FumBlau/DropAlert/Hardware/Drop_no sleep/outputs proyecto/Drop_back.jpg

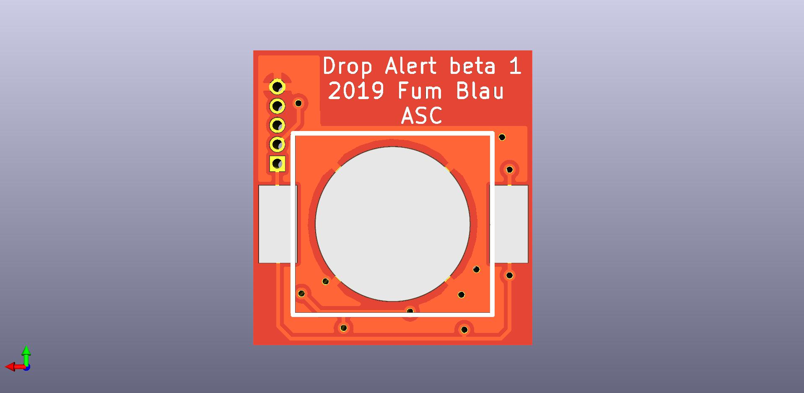
Hardware/Drop_no sleep/outputs proyecto/Drop_back.jpg
