FumBlau/DropAlert/Hardware/Drop_no sleep/outputs proyecto/Drop_front.jpg

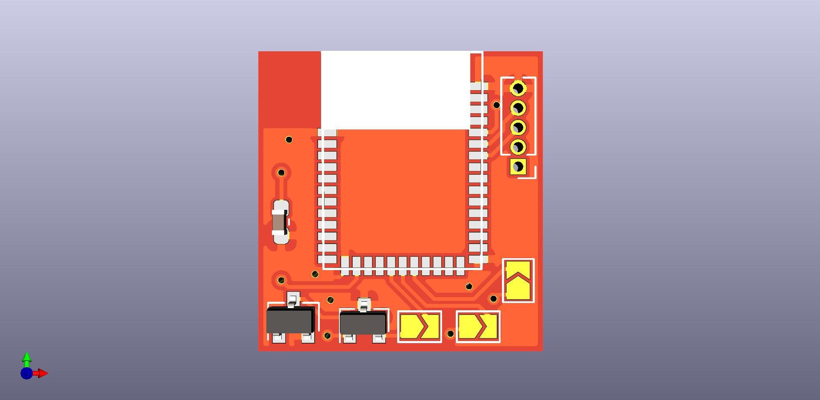
Hardware/Drop_no sleep/outputs proyecto/Drop_front.jpg
