FumBlau/DropAlert/README.md

# DropAlert
Dispositivo de asistencia para su uso con perros guia
