FumBlau/DropAlert/encapsulado/cajaBlue.stl

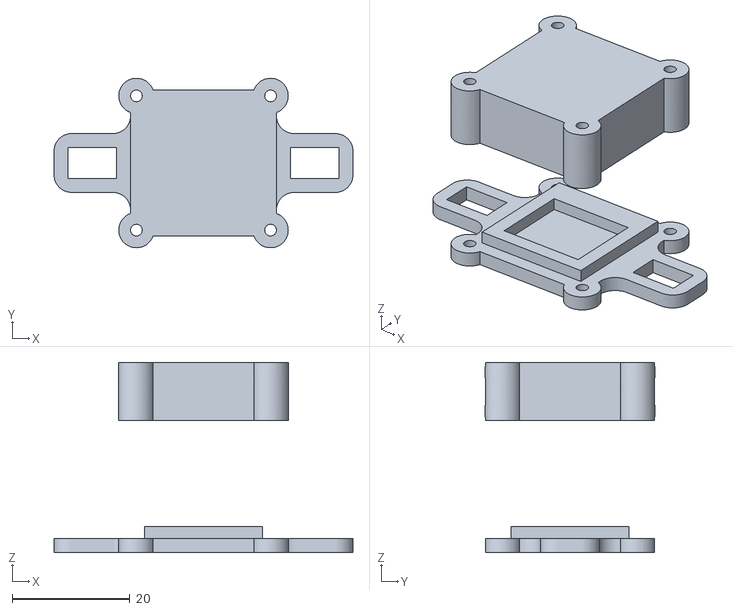
[picture p4: CAD file, 2019-07-10]
encapsulado/cajaBlue.stl
50.8 x 28.8 x 32.3
