FumBlau/DropAlert/Hardware/Drop_no sleep/Drop.kicad_pcb

## KiCad design Hardware/Drop_no sleep/Drop.kicad_pcb (2019-06-28)

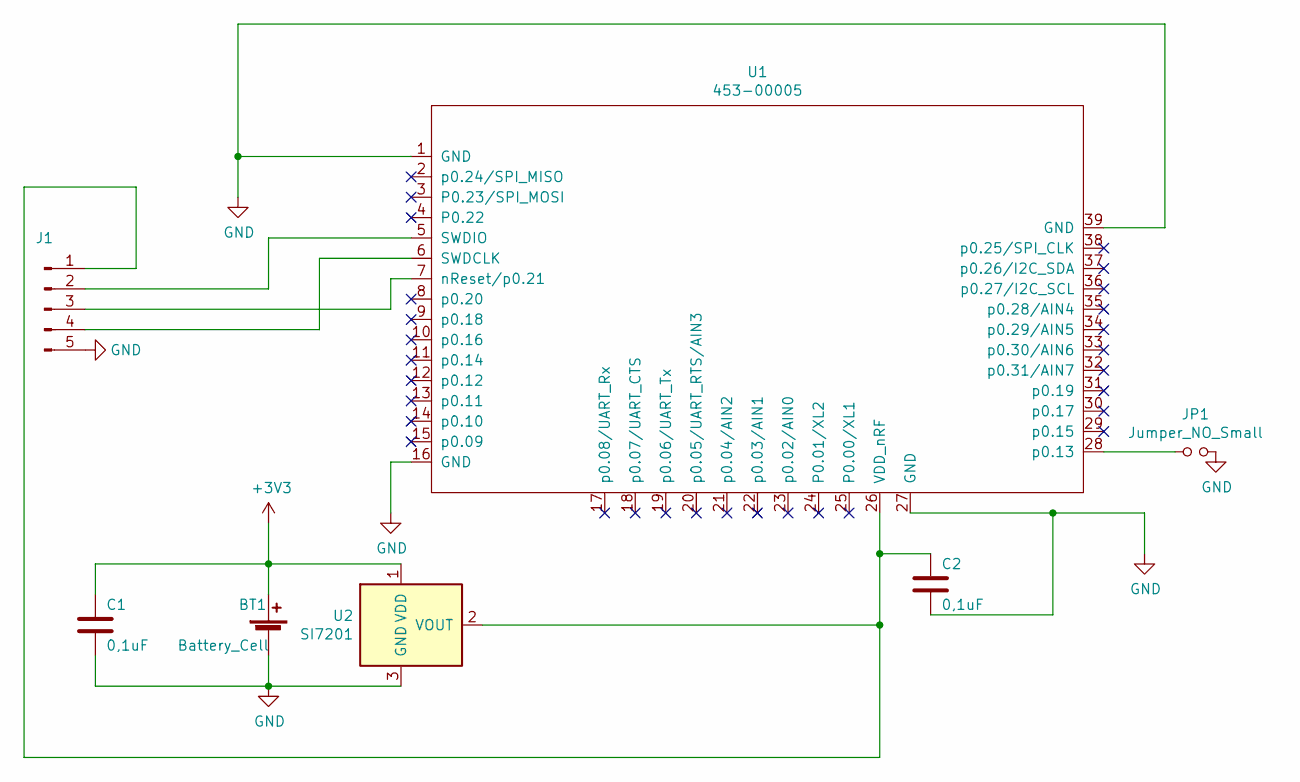
[picture p5: schematic Drop.sch]

Parts:
BT1: Battery_Cell; CR1216_holder_mouser_bat_hld_012_smt
C1, C2: 0,1uF; C_0603_1608Metric_Pad1.05x0.95mm_HandSolder
J1: Conn_01x05_Male; PinHeader_1x05_P1.27mm_Vertical
JP1: Jumper_NO_Small; SolderJumper-2_P1.3mm_Open_TrianglePad1.0x1.5mm
U1: 453-00005; 453-0005
U2: SI7201; SOT-23

Connections:
+3V3: BT1.1 (+), C1.1, U2.1 (VDD)
GND: BT1.2 (-), C1.2, C2.2, J1.5, JP1.2, U1.1 (GND), U1.16 (GND), U1.27 (GND), U1.39 (GND), U2.3 (GND)
unnamed: C2.1, J1.1, U1.26 (VDD_nRF), U2.2 (VOUT)
unnamed: J1.2, U1.5 (SWDIO)
unnamed: J1.3, U1.7 (nReset/p0.21)
unnamed: J1.4, U1.6 (SWDCLK)
unnamed: JP1.1, U1.28 (p0.13)

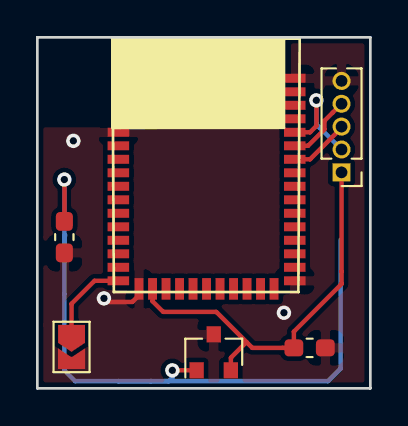
[picture p6: board Drop.kicad_pcb from above]

Board: 2 copper layers, 18.5 x 19.5 mm, 7 parts (1 on the bottom side), 7 nets.
