FumBlau/DropAlert/Hardware/expansion bluetooth/expansion/expansion.kicad_pcb

## KiCad design Hardware/expansion bluetooth/expansion/expansion.kicad_pcb (2019-05-22)

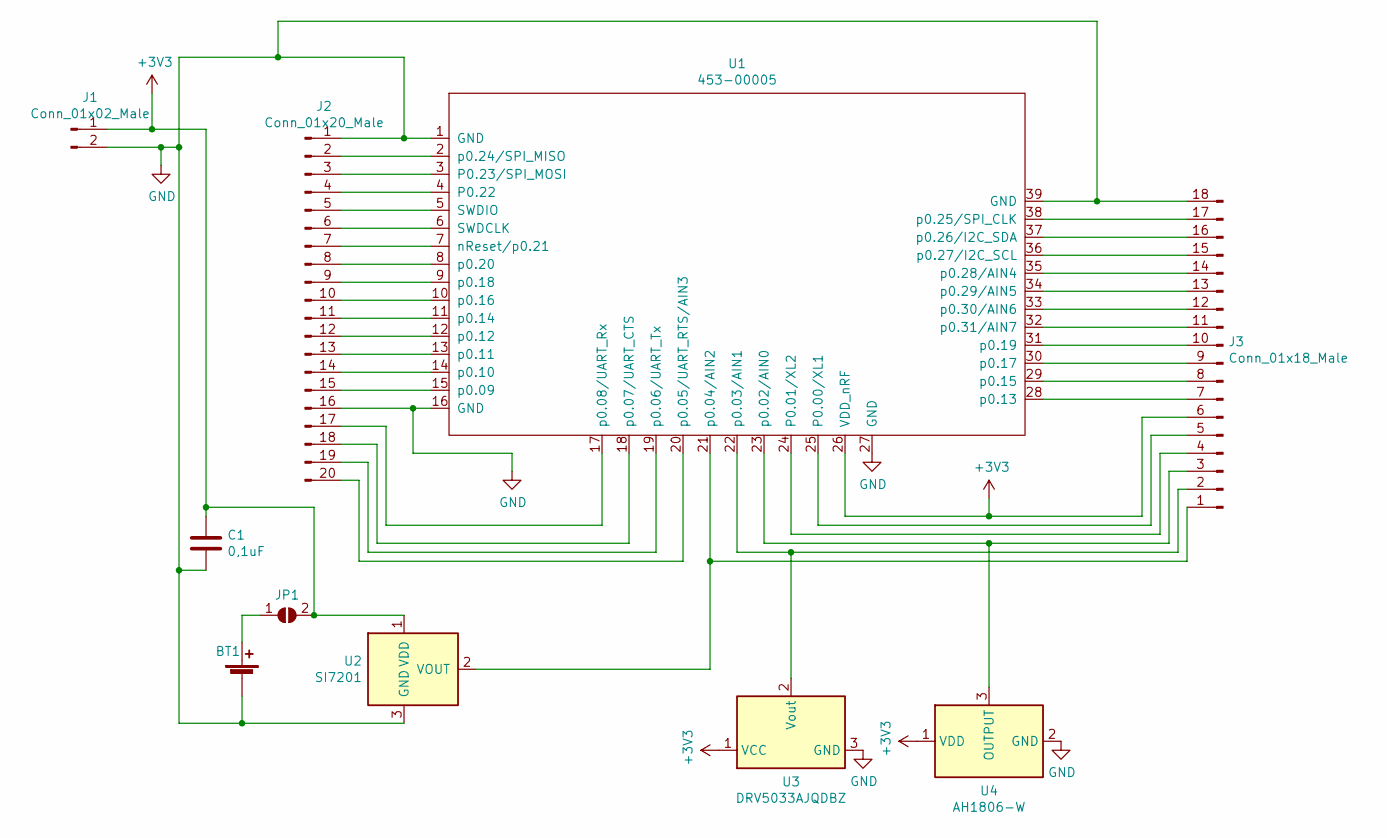
[picture p7: schematic expansion.sch]

Parts:
BT1: Battery_Cell; CR1216_holder_mouser_bat_hld_012_smt
C1: 0,1uF; C_0603_1608Metric_Pad1.05x0.95mm_HandSolder
J1: Conn_01x02_Male; PinHeader_1x02_P2.54mm_Vertical
J2: Conn_01x20_Male; PinHeader_1x20_P2.54mm_Vertical
J3: Conn_01x18_Male; PinHeader_1x18_P2.54mm_Vertical
JP1: SolderJumper_2_Open; SolderJumper-2_P1.3mm_Open_RoundedPad1.0x1.5mm
U1: 453-00005; 453-0005
U2: SI7201; SOT-23
U3: DRV5033AJQDBZ; SOT-23
U4: AH1806-W; SC-59

Connections:
+3V3: C1.1, J1.1, J3.6, JP1.2 (B), U1.26 (VDD_nRF), U2.1 (VDD), U3.1 (VCC), U4.1 (VDD)
GND: BT1.2 (-), C1.2, J1.2, J2.1, J2.16, J3.18, U1.1 (GND), U1.16 (GND), U1.27 (GND), U1.39 (GND), U2.3 (GND), U3.3 (GND), U4.2 (GND)
unnamed: BT1.1 (+), JP1.1 (A)
unnamed: J2.2, U1.2 (p0.24/SPI_MISO)
unnamed: J2.3, U1.3 (P0.23/SPI_MOSI)
unnamed: J2.4, U1.4 (P0.22)
unnamed: J2.5, U1.5 (SWDIO)
unnamed: J2.6, U1.6 (SWDCLK)
unnamed: J2.7, U1.7 (nReset/p0.21)
unnamed: J2.8, U1.8 (p0.20)
unnamed: J2.9, U1.9 (p0.18)
unnamed: J2.10, U1.10 (p0.16)
unnamed: J2.11, U1.11 (p0.14)
unnamed: J2.12, U1.12 (p0.12)
unnamed: J2.13, U1.13 (p0.11)
unnamed: J2.14, U1.14 (p0.10)
unnamed: J2.15, U1.15 (p0.09)
unnamed: J2.17, U1.17 (p0.08/UART_Rx)
unnamed: J2.18, U1.18 (p0.07/UART_CTS)
unnamed: J2.19, U1.19 (p0.06/UART_Tx)
unnamed: J2.20, U1.20 (p0.05/UART_RTS/AIN3)
unnamed: J3.1, U1.21 (p0.04/AIN2), U2.2 (VOUT)
unnamed: J3.2, U1.22 (p0.03/AIN1), U3.2 (Vout)
unnamed: J3.3, U1.23 (p0.02/AIN0), U4.3 (OUTPUT)
unnamed: J3.4, U1.24 (P0.01/XL2)
unnamed: J3.5, U1.25 (P0.00/XL1)
unnamed: J3.7, U1.28 (p0.13)
unnamed: J3.8, U1.29 (p0.15)
unnamed: J3.9, U1.30 (p0.17)
unnamed: J3.10, U1.31 (p0.19)
unnamed: J3.11, U1.32 (p0.31/AIN7)
unnamed: J3.12, U1.33 (p0.30/AIN6)
unnamed: J3.13, U1.34 (p0.29/AIN5)
unnamed: J3.14, U1.35 (p0.28/AIN4)
unnamed: J3.15, U1.36 (p0.27/I2C_SCL)
unnamed: J3.16, U1.37 (p0.26/I2C_SDA)
unnamed: J3.17, U1.38 (p0.25/SPI_CLK)

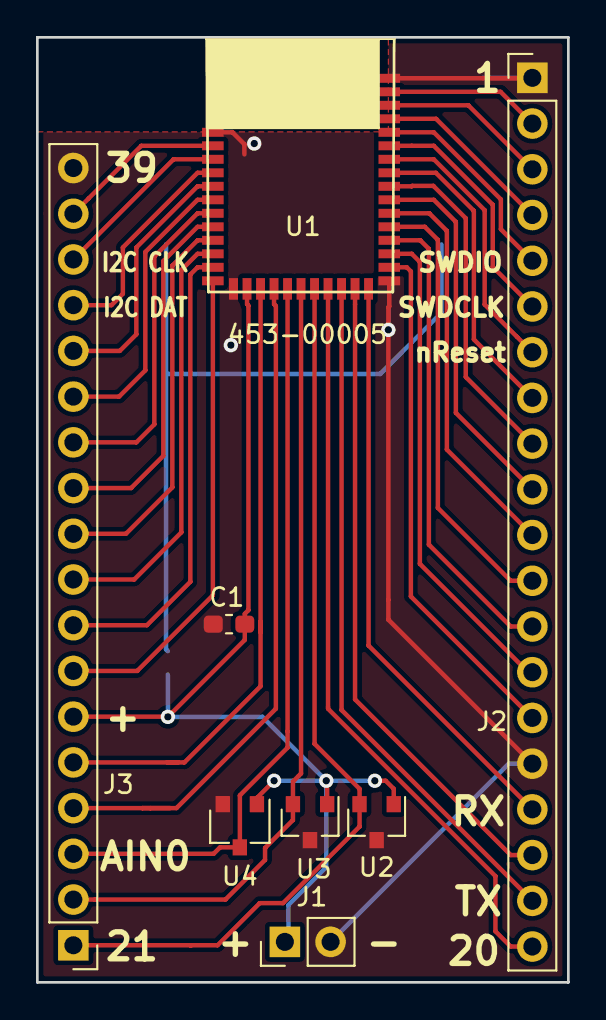
[picture p8: board expansion.kicad_pcb from above]

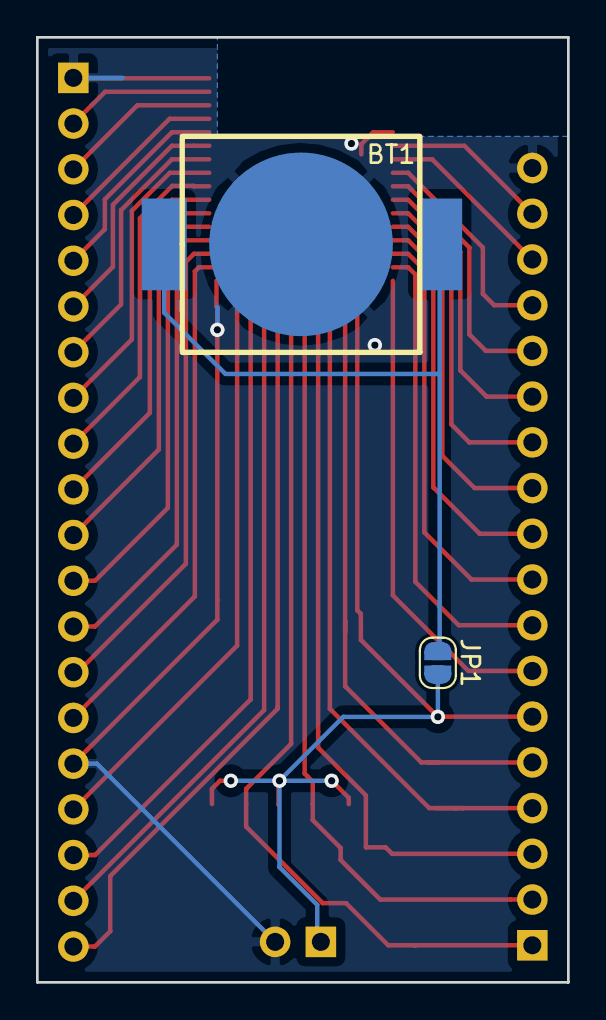
[picture p9: board expansion.kicad_pcb from below]

Board: 2 copper layers, 29.5 x 52.5 mm, 10 parts (2 on the bottom side), 37 nets.
