FumBlau/DropAlert/(commit log)

2019-03-25 First steps to connect devices via bluetooth
2019-05-22 Beta 1 de hardware
    [Drop.kicad_pcb, Drop.sch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]
2019-06-28 - Añado versión no-sleep
    [Drop-B_Cu.gbr, Drop-B_Mask.gbr, Drop-B_SilkS.gbr, Drop-Edge_Cuts.gbr, Drop-F_Cu.gbr, Drop-F_Mask.gbr, Drop-F_SilkS.gbr, Drop-NPTH.drl]
2019-07-10 - Añado v1 de encapsulado
    [cajaBlue.stl]
